nathan546/garageOpener/Bluetooth Garage Opener V2/Case/case2-view.fcstd

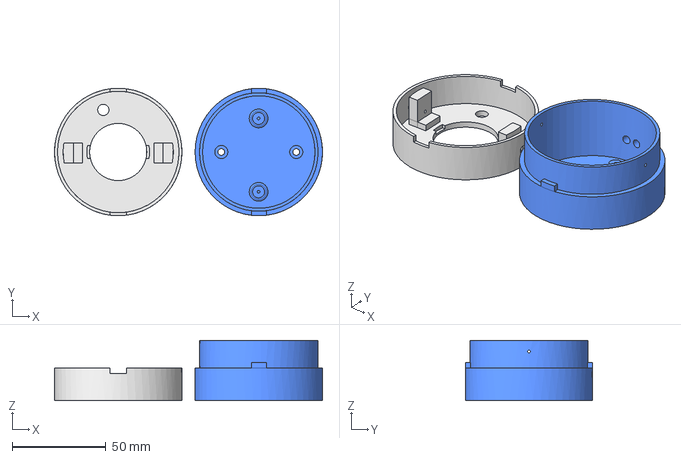
[picture p1: CAD file, 2016-04-04]
Bluetooth Garage Opener V2/Case/case2-view.fcstd
143.0 x 68.0 x 32.2 mm
