nathan546/garageOpener/Bluetooth Garage Opener/helix.FCStd

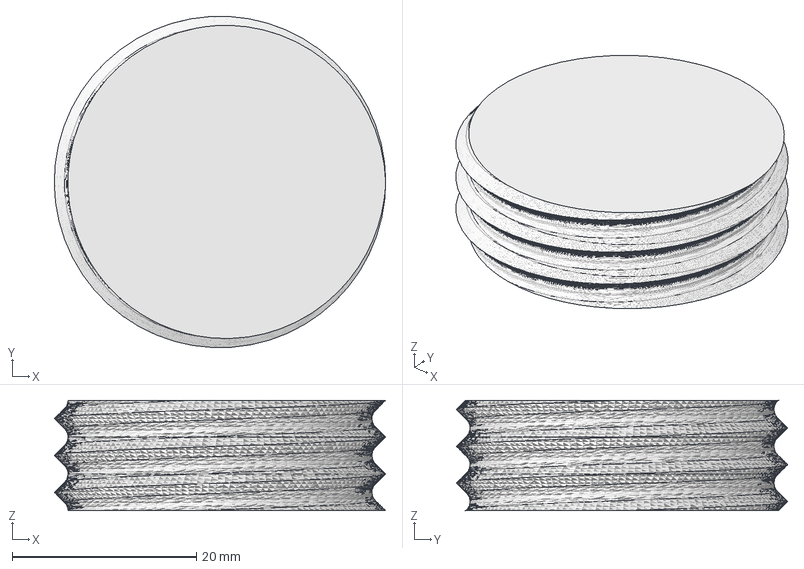
[picture p2: CAD file, 2016-04-04, an earlier design]
Bluetooth Garage Opener/helix.FCStd
36.0 x 36.0 x 12.0 mm
