nathan546/garageOpener/Bluetooth Garage Opener/pfetreg.brd

## EAGLE design Bluetooth Garage Opener/pfetreg.brd (2016-04-04, an earlier design)

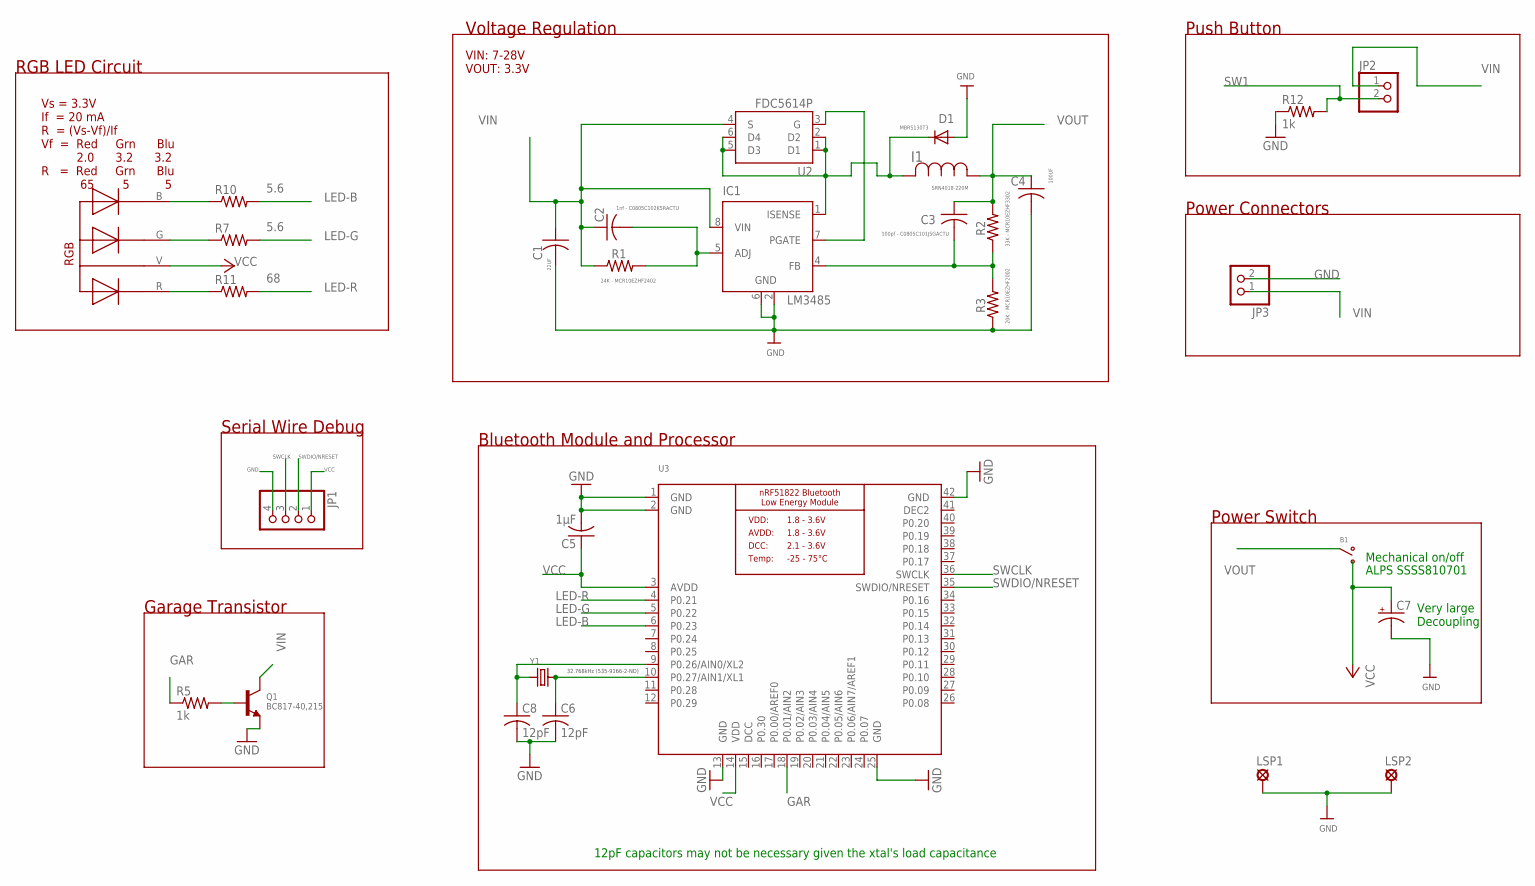
[picture p3: schematic pfetreg.sch]

Parts:
B1: SSSS810701
C1: 22UF; CAPCP7343X430N
C2: 1nf - C0805C102K5RACTU; C0805K
C3: 100pf - C0805C101J5GACTU; C0805K
C4: 100UF; CAPCP7343X430N
C5: 1µF; C0805K
C6, C8: 12pF; C0805
C7: CPOL-USE5-10.5; E5-10,5
D1: MBRS130T3; DO214AA
I1: SRN4018-220M
IC1: LM3485; MSOP08
JP1: PINHD-1X4; 1X04
JP2, JP3: PINHD-1X2; 1X02
LSP1, LSP2: LSP11
Q1: BC817-40,215; SOT23-R
R1: 24K - MCR10EZHF2402; R0805W
R2: 33K - MCR10EZHF3302; R0805W
R3: 20K - MCR10EZHF2002; R0805W
R5, R12: 1k; R0805
R7, R10: 5.6; R0805
R11: 68; R0805
RGB: 5MMRGBLED; LED5MMRGB
U2: FDC5614PSOT-23; SOT23-6
U3: NRF51822_MODULE_MDBT40; BLE_MODULE_RAYTAC_MDBT40
Y1: CRYSTAL8X3.8SMT; CRYSTAL_8X3.8

Connections:
DCC: U3.15 (DCC)
DEC2: U3.41 (DEC2)
GAR: R5.1, U3.18 (P0.01/AIN2)
GND: C1.2 (I2), C4.2 (I2), C5.2, C6.2, C7.-, C8.2, D1.A, IC1.2 (GND), IC1.6 (GND), JP1.4, JP3.2, LSP1.MP, LSP2.MP, Q1.2 (E), R3.1, R12.1, U3.1 (GND), U3.2 (GND), U3.13 (GND), U3.25 (GND), U3.42 (GND)
LED-B: R10.2, U3.6 (P0.23)
LED-G: R7.2, U3.5 (P0.22)
LED-R: R11.2, U3.4 (P0.21)
unnamed: D1.C, I1.1 (I1), IC1.1 (ISENSE), U2.1 (D1), U2.2 (D2), U2.5 (D3), U2.6 (D4)
unnamed: C3.2, IC1.4 (FB), R2.1, R3.2
unnamed: IC1.7 (PGATE), U2.3 (G)
unnamed: C2.2, IC1.5 (ADJ), R1.2
unnamed: Q1.1 (B), R5.2
unnamed: R7.1, RGB.G
unnamed: R10.1, RGB.B
unnamed: R11.1, RGB.R
unnamed: C8.1, U3.9 (P0.26/AIN0/XL2), Y1.P$1 (1)
unnamed: C6.1, U3.10 (P0.27/AIN1/XL1), Y1.P$4 (2)
SW1: JP2.2, R12.2
SWCLK: JP1.3, U3.36 (SWCLK)
SWDIO/NRESET: JP1.2, U3.35 (SWDIO/NRESET)
VCC: B1.1 (B), C5.1, C7.+, JP1.1, RGB.V, U3.3 (AVDD), U3.14 (VDD)
VIN: C1.1 (I1), C2.1, IC1.8 (VIN), JP2.1, JP3.1, Q1.3 (C), R1.1, U2.4 (S)
VOUT: B1.2 (COM), C3.1, C4.1 (I1), I1.2 (I2), R2.2

Notes on the sheet:
VIN: 7-28V VOUT: 3.3V
32.768kHz (535-9166-2-ND)
Bluetooth Module and Processor
12pF capacitors may not be necessary given the xtal's load capacitance
Vs = 3.3V If = 20 mA R = (Vs-Vf)/If Vf = Red Grn Blu 2.0 3.2 3.2 R = Red Grn Blu 65 5 5
RGB LED Circuit
Voltage Regulation
Push Button
Power Switch
Mechanical on/off
ALPS SSSS810701
Serial Wire Debug
Garage Transistor
Power Connectors
Very large Decoupling

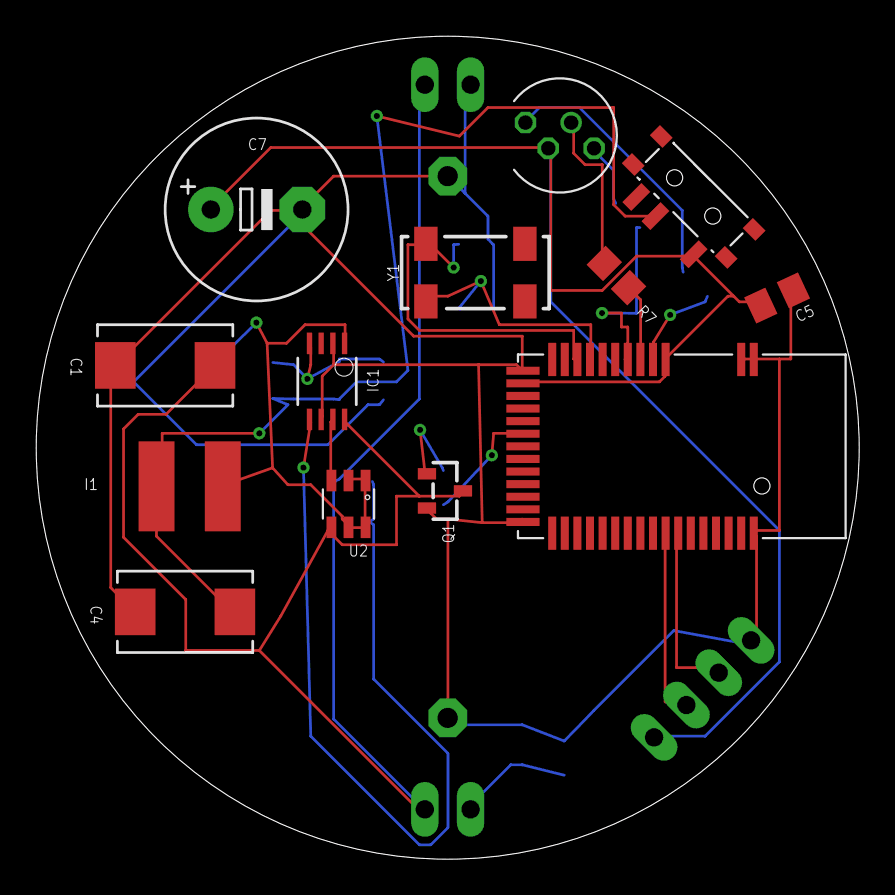
[picture p4: board pfetreg.brd from above]

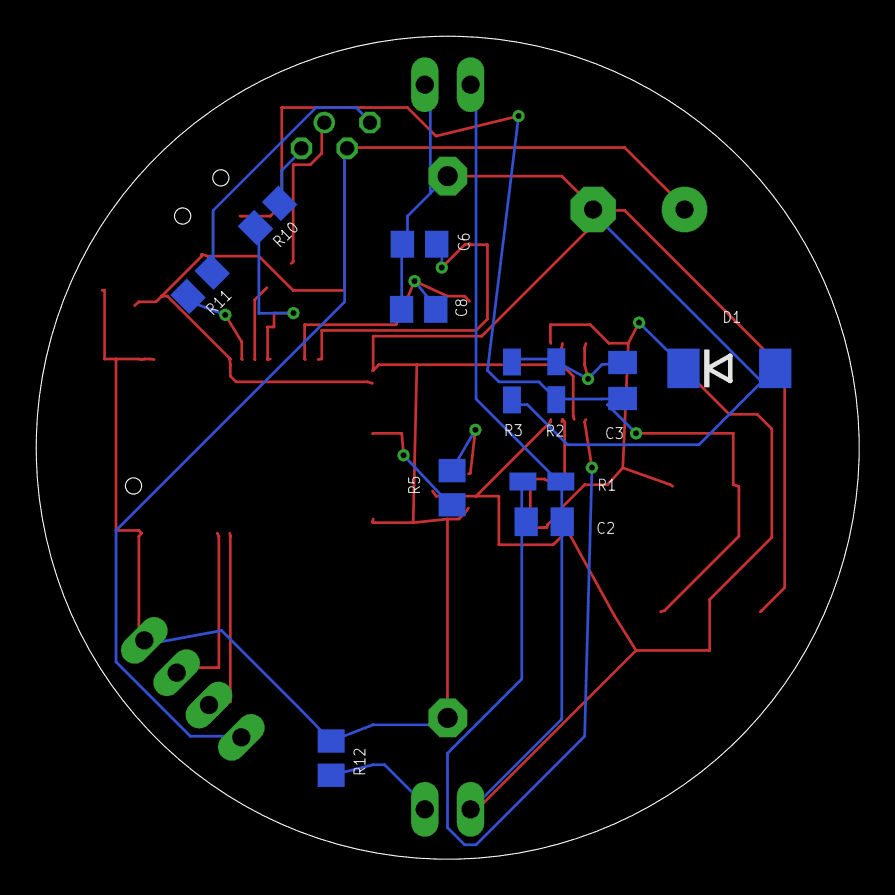
[picture p5: board pfetreg.brd from below]

Board: 2 copper layers, 45.7 x 45.7 mm, 30 parts (12 on the bottom side), 21 nets.
